RobJansen62/Self-driving-Robot-Wagon/hardware/Connections.JPG

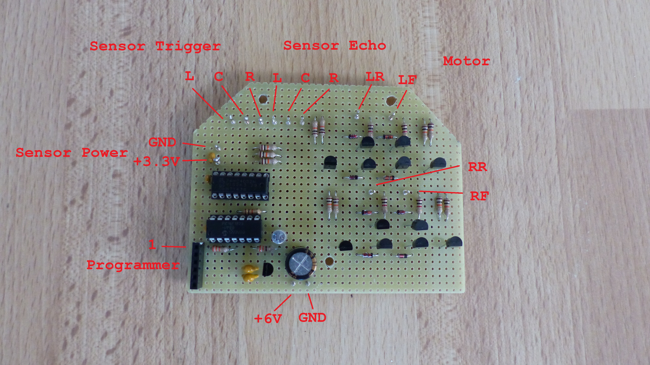
hardware/Connections.JPG
