RobJansen62/Self-driving-Robot-Wagon/hardware/Top_View.JPG

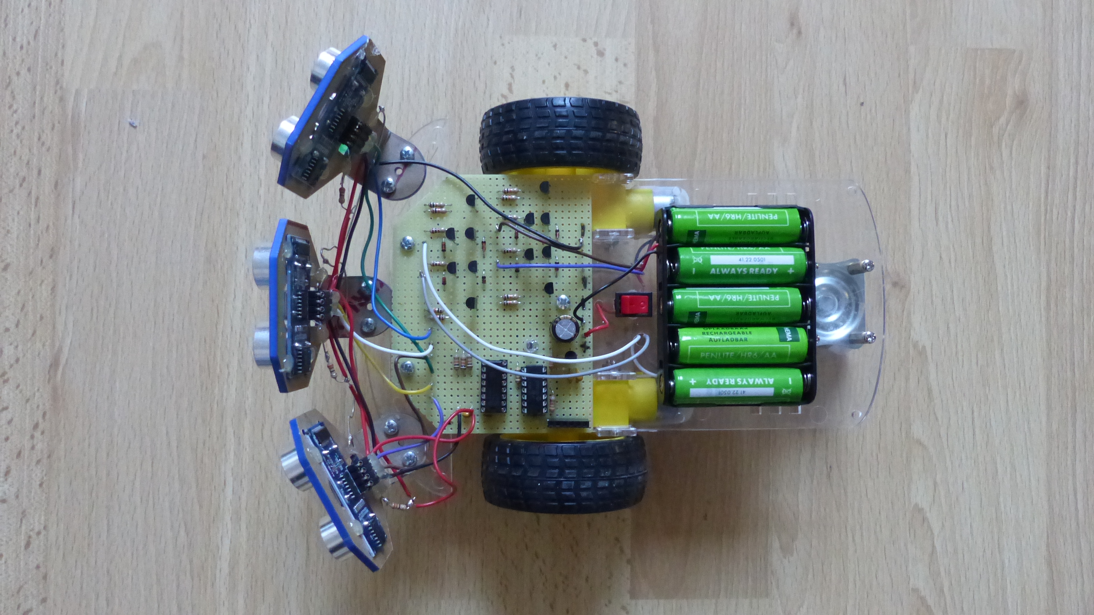
hardware/Top_View.JPG
