RobJansen62/Self-driving-Robot-Wagon/README.md

# Self-driving-Robot-Wagon
A self driving Robot Wagon using three HC-SR04 Ultrasonic Distance Sensors controlled with a PIC Microcontroller.

The software is created using the [JAL programming language](http://justanotherlanguage.org/).

For a demo, have a look at this [video](https://youtu.be/kwYxd5GjtCw).
