RobJansen62/Self-driving-Robot-Wagon/hardware/README.txt

This folder contains the schematic diagram of the Self driving Robot Wagon
The schematic diagram is made with KiCAD 8.0.
