RobJansen62/Self-driving-Robot-Wagon/documentation/Front.JPG

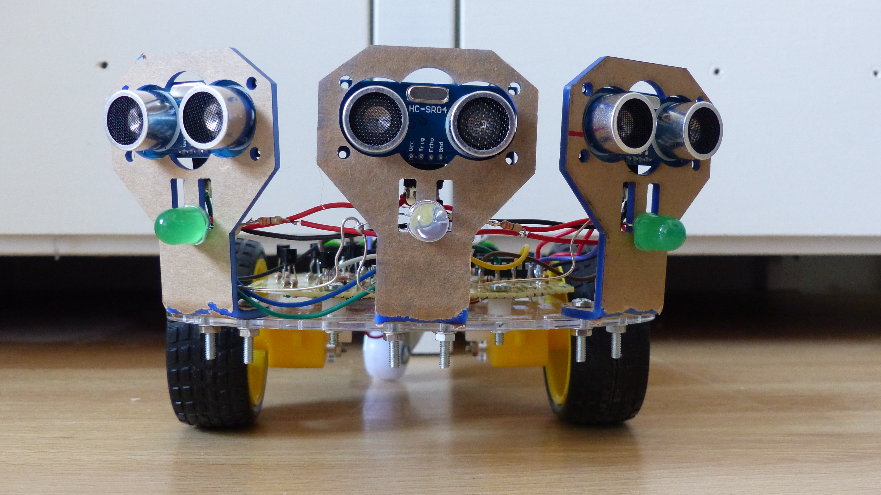
documentation/Front.JPG
