RobJansen62/Self-driving-Robot-Wagon/documentation/Front_With_LED_On.JPG

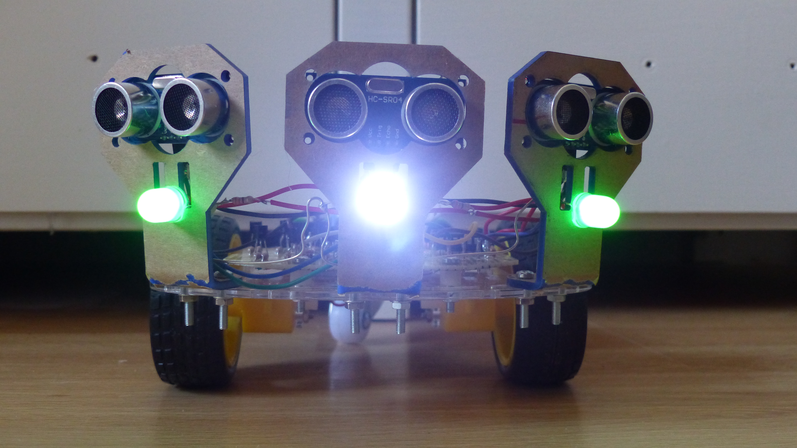
documentation/Front_With_LED_On.JPG
