RobJansen62/Self-driving-Robot-Wagon/hardware/16f1823_Robot_Wagon.pdf

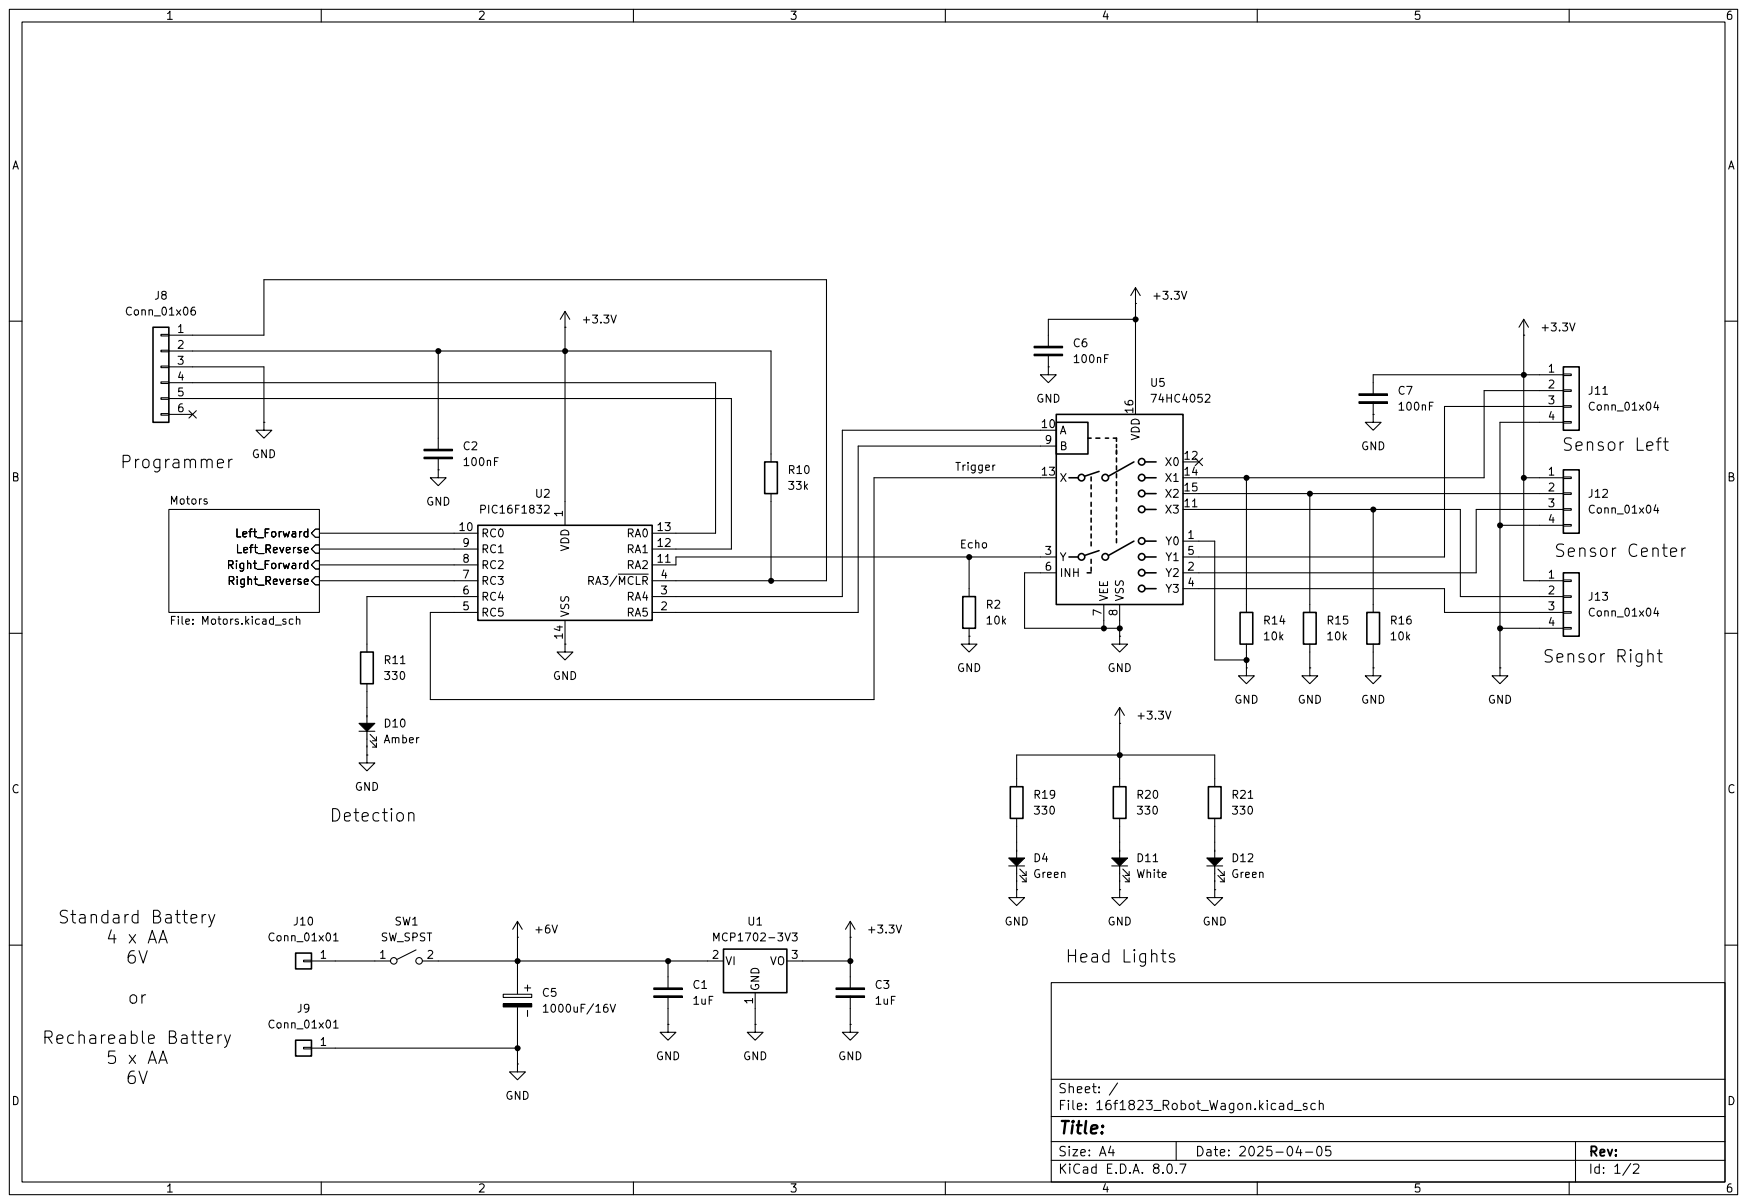
[picture p5: page 1]

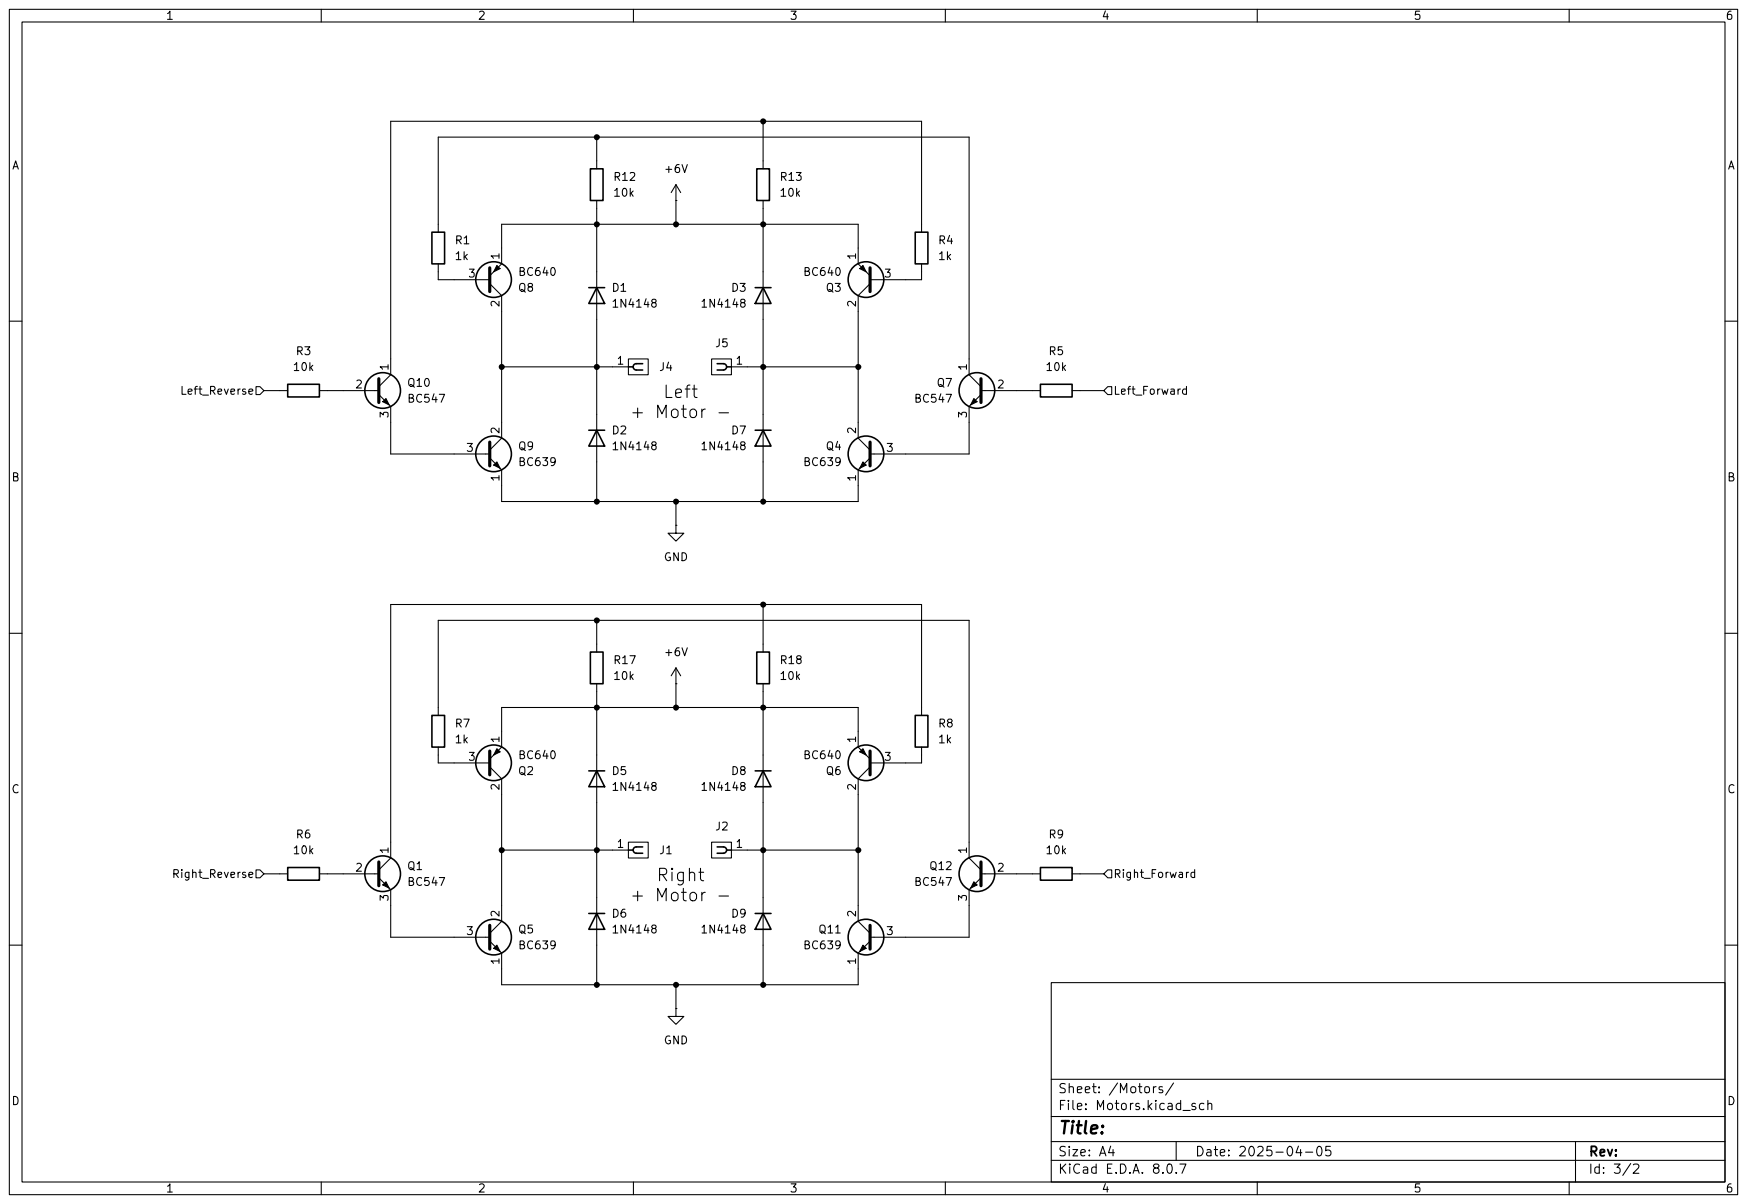
[picture p6: page 2]
