RobJansen62/Self-driving-Robot-Wagon/hardware/16f1823_Robot_Wagon.kicad_sch

## KiCad design hardware/16f1823_Robot_Wagon.kicad_sch (2025-04-05)

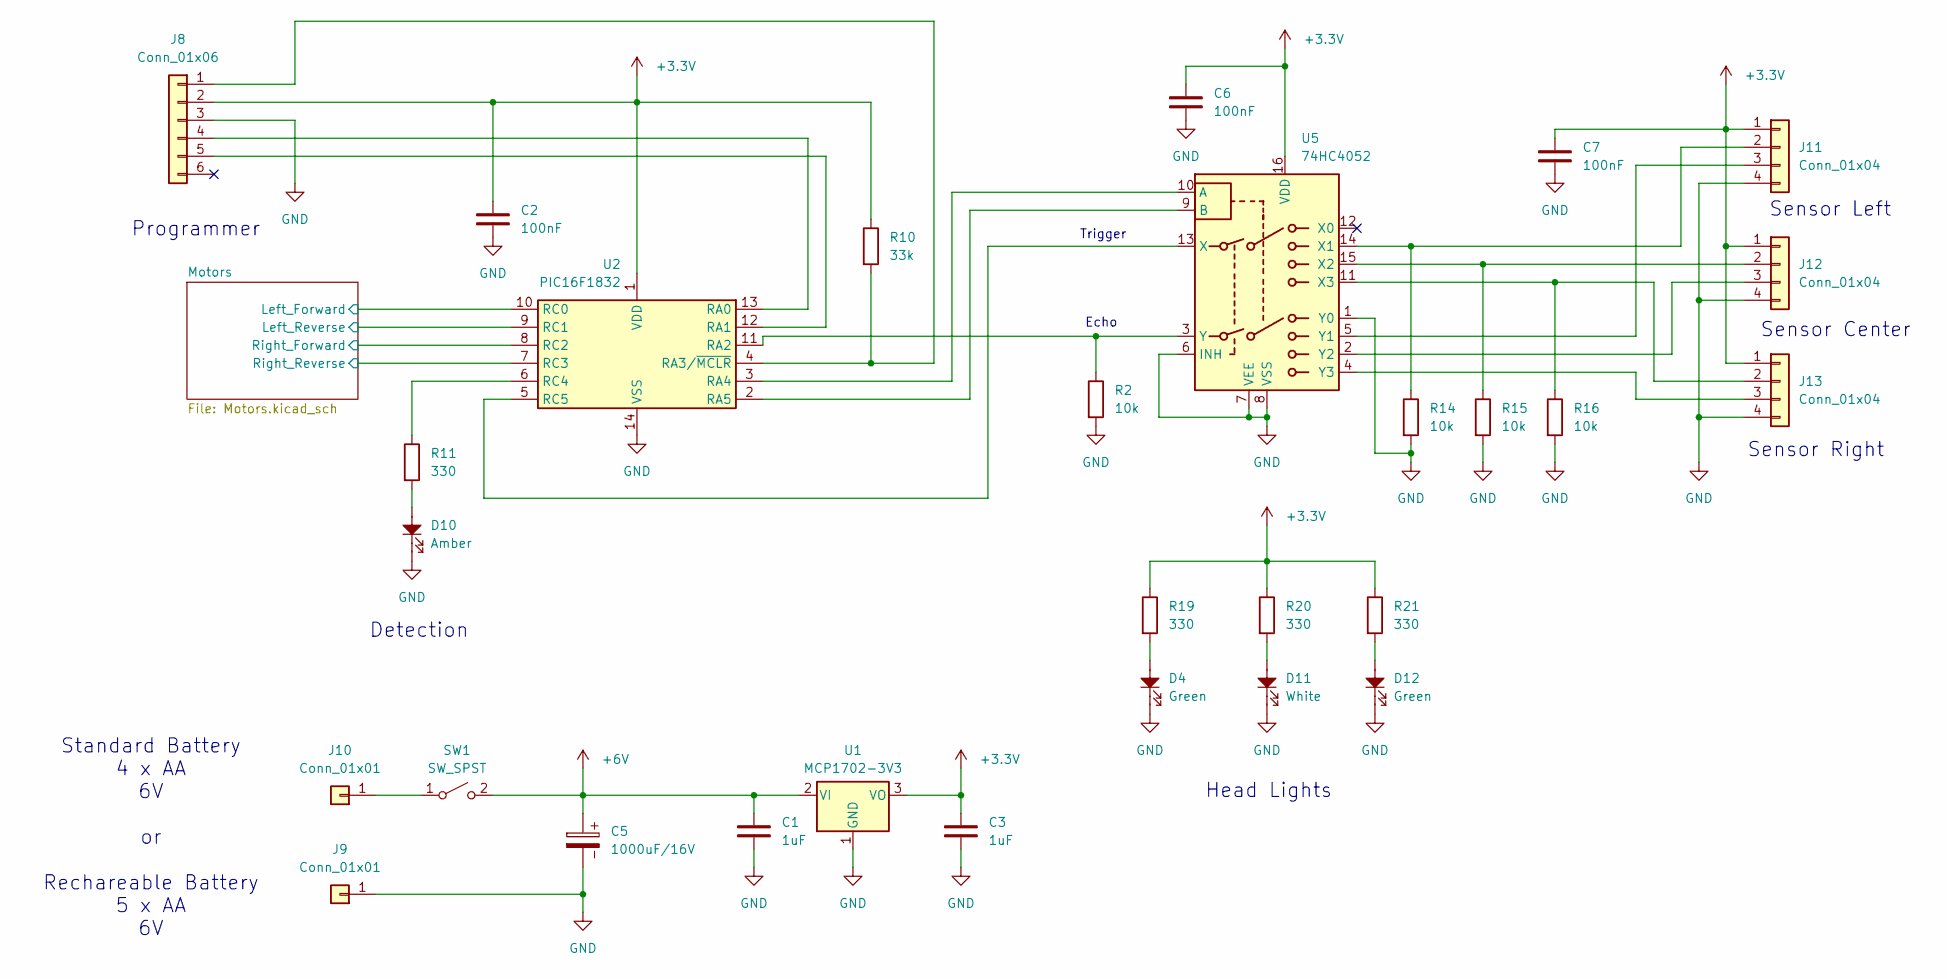
[picture p7: schematic 16f1823_Robot_Wagon.kicad_sch]

Parts:
C1, C3: 1uF; C_Disc_D3.0mm_W2.0mm_P2.50mm
C2, C6, C7: 100nF; C_Disc_D3.0mm_W2.0mm_P2.50mm
C5: 1000uF/16V; CP_Radial_D5.0mm_P2.50mm
D4, D12: Green; LED_D5.0mm
D10: Amber; LED_D5.0mm
D11: White; LED_D5.0mm
J8: Conn_01x06
J9, J10: Conn_01x01
J11, J12, J13: Conn_01x04
R2, R14, R15, R16: 10k
R10: 33k
R11, R19, R20, R21: 330
SW1: SW_SPST
U1: MCP1702-3V3; SOT-89-3
U2: PIC16F1832; SOIC-14_3.9x8.7mm_P1.27mm
U5: 74HC4052

Connections:
+3.3V: C2.2, C3.2, C6.2, C7.2, J8.2, J11.1, J12.1, J13.1, R10.1, R19.1, R20.1, R21.1, U1.3 (VO), U2.1 (VDD), U5.16 (VDD)
+6V: C1.2, C5.1, SW1.2 (B), U1.2 (VI)
GND: C1.1, C2.1, C3.1, C5.2, C6.1, C7.1, D4.1, D10.1, D11.1, D12.1, J8.3, J9.1, J11.4, J12.4, J13.4, R2.2, R14.2, R15.2, R16.2, U1.1 (GND), U2.14 (VSS), U5.1 (Y0), U5.6 (INH), U5.7 (VEE), U5.8 (VSS)
Left_Forward: U2.10 (RC0)
Left_Reverse: U2.9 (RC1)
unnamed: D4.2, R19.2
unnamed: D10.2, R11.2
unnamed: D11.2, R20.2
unnamed: D12.2, R21.2
unnamed: J8.1, R10.2, U2.4 (RA3/~MCLR)
unnamed: J8.4, U2.13 (RA0)
unnamed: J8.5, U2.12 (RA1)
unnamed: J10.1, SW1.1 (A)
unnamed: J11.2, R14.1, U5.14 (X1)
unnamed: J11.3, U5.5 (Y1)
unnamed: J12.2, R15.1, U5.15 (X2)
unnamed: J12.3, U5.2 (Y2)
unnamed: J13.2, R16.1, U5.11 (X3)
unnamed: J13.3, U5.4 (Y3)
unnamed: R2.1, U2.11 (RA2), U5.3 (Y)
unnamed: R11.1, U2.6 (RC4)
unnamed: U2.2 (RA5), U5.9 (B)
unnamed: U2.3 (RA4), U5.10 (A)
unnamed: U2.5 (RC5), U5.13 (X)
Right_Forward: U2.8 (RC2)
Right_Reverse: U2.7 (RC3)

Notes on the sheet:
Sensor Right
Standard Battery 4 x AA 6V or Rechareable Battery 5 x AA 6V
Programmer
Trigger
Detection
Sensor Center
Head Lights
Sensor Left
Echo
