RobJansen62/Self-driving-Robot-Wagon/hardware/Motors.kicad_sch

## KiCad design hardware/Motors.kicad_sch (2025-04-08)

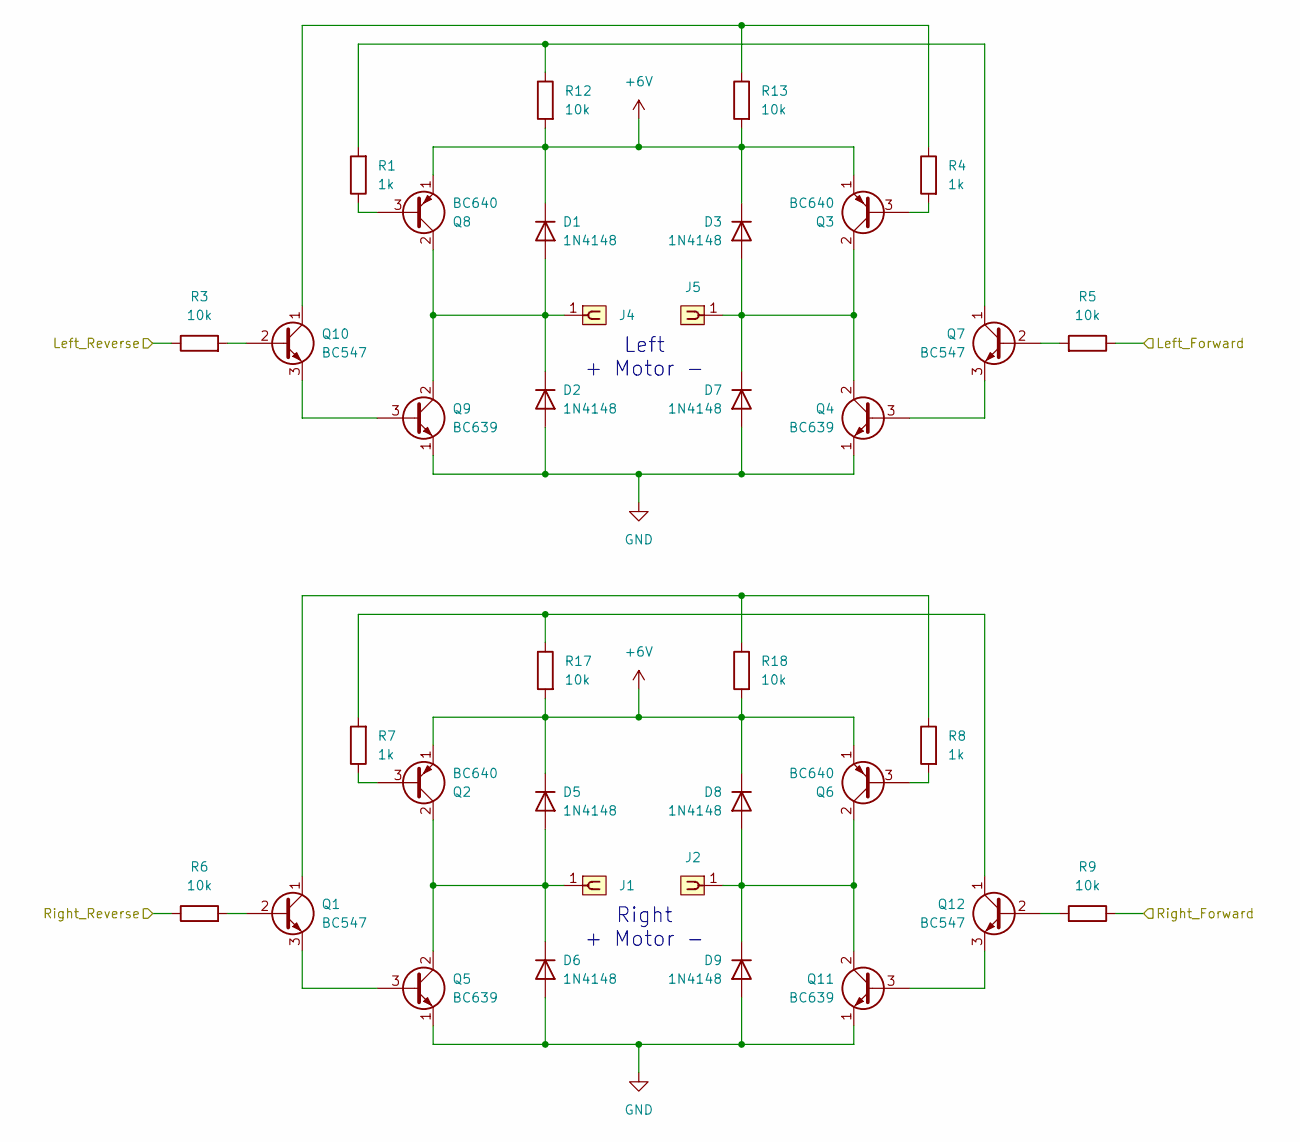
[picture p8: schematic Motors.kicad_sch]

Parts:
D1, D2, D3, D5, D6, D7, D8, D9: 1N4148; D_DO-35_SOD27_P7.62mm_Horizontal
J1, J2, J4, J5: PINHD_1x1_Female; PinSocket_1x01_P2.54mm_Vertical
Q1, Q7, Q10, Q12: BC547; TO-92_Inline
Q2, Q3, Q6, Q8: BC640; TO-92_Inline
Q4, Q5, Q9, Q11: BC639; TO-92_Inline
R1, R4, R7, R8: 1k
R3, R5, R6, R9, R12, R13, R17, R18: 10k

Connections:
+6V: D1.1 (K), D3.1 (K), D5.1 (K), D8.1 (K), Q2.1 (E), Q3.1 (E), Q6.1 (E), Q8.1 (E), R12.2, R13.2, R17.2, R18.2
GND: D2.2 (A), D6.2 (A), D7.2 (A), D9.2 (A), Q4.1 (E), Q5.1 (E), Q9.1 (E), Q11.1 (E)
Left_Forward: R5.1
Left_Reverse: R3.1
unnamed: D1.2 (A), D2.1 (K), J4.1, Q8.2 (C), Q9.2 (C)
unnamed: D3.2 (A), D7.1 (K), J5.1, Q3.2 (C), Q4.2 (C)
unnamed: D5.2 (A), D6.1 (K), J1.1, Q2.2 (C), Q5.2 (C)
unnamed: D8.2 (A), D9.1 (K), J2.1, Q6.2 (C), Q11.2 (C)
unnamed: Q1.1 (C), R8.1, R18.1
unnamed: Q1.2 (B), R6.2
unnamed: Q1.3 (E), Q5.3 (B)
unnamed: Q2.3 (B), R7.1
unnamed: Q3.3 (B), R4.2
unnamed: Q4.3 (B), Q7.3 (E)
unnamed: Q6.3 (B), R8.2
unnamed: Q7.1 (C), R1.2, R12.1
unnamed: Q7.2 (B), R5.2
unnamed: Q8.3 (B), R1.1
unnamed: Q10.1 (C), R4.1, R13.1
unnamed: Q10.2 (B), R3.2
unnamed: Q9.3 (B), Q10.3 (E)
unnamed: Q11.3 (B), Q12.3 (E)
unnamed: Q12.1 (C), R7.2, R17.1
unnamed: Q12.2 (B), R9.2
Right_Forward: R9.1
Right_Reverse: R6.1

Notes on the sheet:
Left + Motor -
Right + Motor -
