RobJansen62/Self-driving-Robot-Wagon/(commit log)

2025-04-05 Project uploaded
    [16f1823_Robot_Wagon.kicad_sch]
2025-04-08 Added Motor schematic and photo of breadboad connections.
    [Motors.kicad_sch]
